openfuck/buttshock-et312-schematics/hardware/README.md

Board size: 19cm x 16.6cm
2nd PCB: 19cm x 2.5cm
(designed as single PCB and broken into two parts)

2 Layers, all through-hole components

Current work is for Revision I
