openfuck/buttshock-et312-schematics/hardware/datasheets/cd4066.png

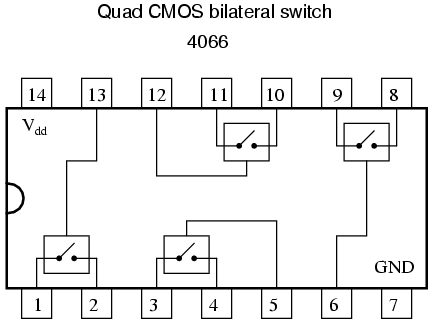
hardware/datasheets/cd4066.png
