openfuck/buttshock-et312-schematics/hardware/datasheets/LM358 pinout.JPG

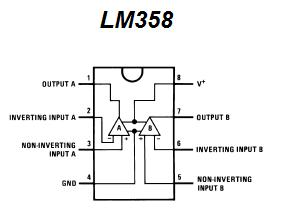
hardware/datasheets/LM358 pinout.JPG
