openfuck/buttshock-et312-schematics/hardware/schematics/et312.brd

## EAGLE design hardware/schematics/et312.brd (2016-06-19)

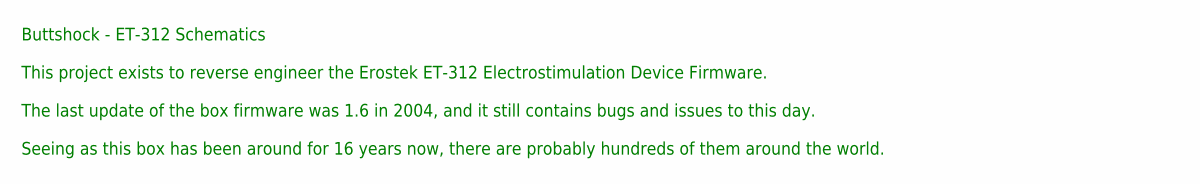
[picture p3: schematic et312.sch, sheet 1, Description Page]

Notes on the sheet:
Buttshock - ET-312 Schematics This project exists to reverse engineer the Erostek ET-312 Electrostimulation Device Firmware. The last update of the box firmware was 1.6 in 2004, and it still contains bugs and issues to this day. Seeing as this box has been around for 16 years now, there are probabl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

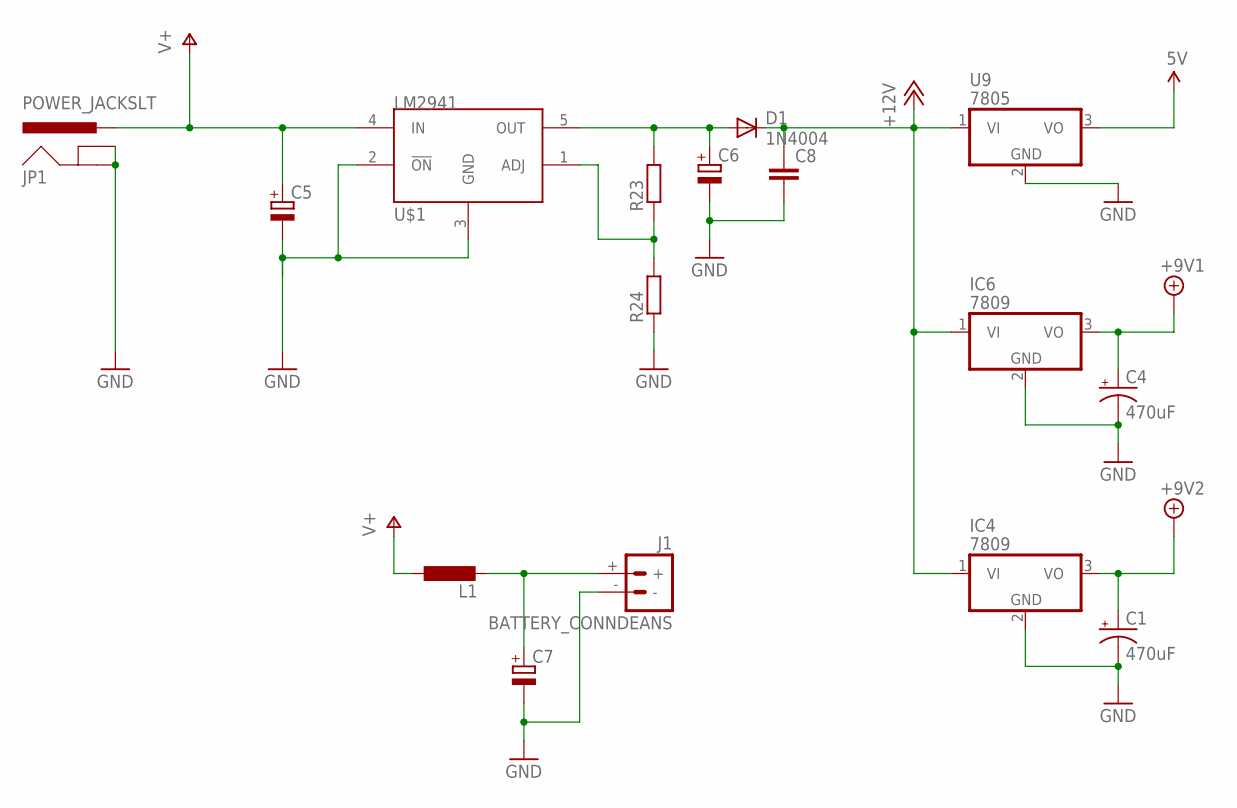
[picture p4: schematic et312.sch, sheet 2, PSU]

Parts:
C1, C4: 470uF; CPOL-RADIAL-100UF-25V
C5: CPOL-EUE2.5-6; E2,5-6
C6, C7: CPOL-EUE3.5-10; E3,5-10
C8: C-EU050-025X075; C050-025X075
D1: 1N4004; DO41-10
IC4, IC6: 7809; TO220H
J1: BATTERY_CONNDEANS; DEANS
JP1: POWER_JACKSLT; POWER_JACK_SLOT
L1: L-EU0207/10; 0207/10
R23, R24: R-EU_0204/7; 0204/7
U9: 7805; TO220H
U$1: LM2941; T05A

Connections:
5V: U9.3 (VO); also elsewhere on the board
+9V1: C4.1 (+), IC6.3 (VO); also elsewhere on the board
+9V2: C1.1 (+), IC4.3 (VO); also elsewhere on the board
+12V: C8.1, D1.C, IC4.1 (VI), IC6.1 (VI), U9.1 (VI); also elsewhere on the board
GND: C1.2 (-), C4.2 (-), C5.-, C6.-, C7.-, C8.2, IC4.2 (GND), IC6.2 (GND), J1.-, JP1.GND@1 (GNDBREAK), JP1.GND@2 (GND), R24.1, U9.2 (GND), U$1.2 (!ON), U$1.3 (GND); also elsewhere on the board
unnamed: C7.+, J1.+, L1.2
unnamed: R23.1, R24.2, U$1.1 (ADJ)
unnamed: C6.+, D1.A, R23.2, U$1.5 (OUT)
V+: C5.+, JP1.PWR, L1.1, U$1.4 (IN); also elsewhere on the board

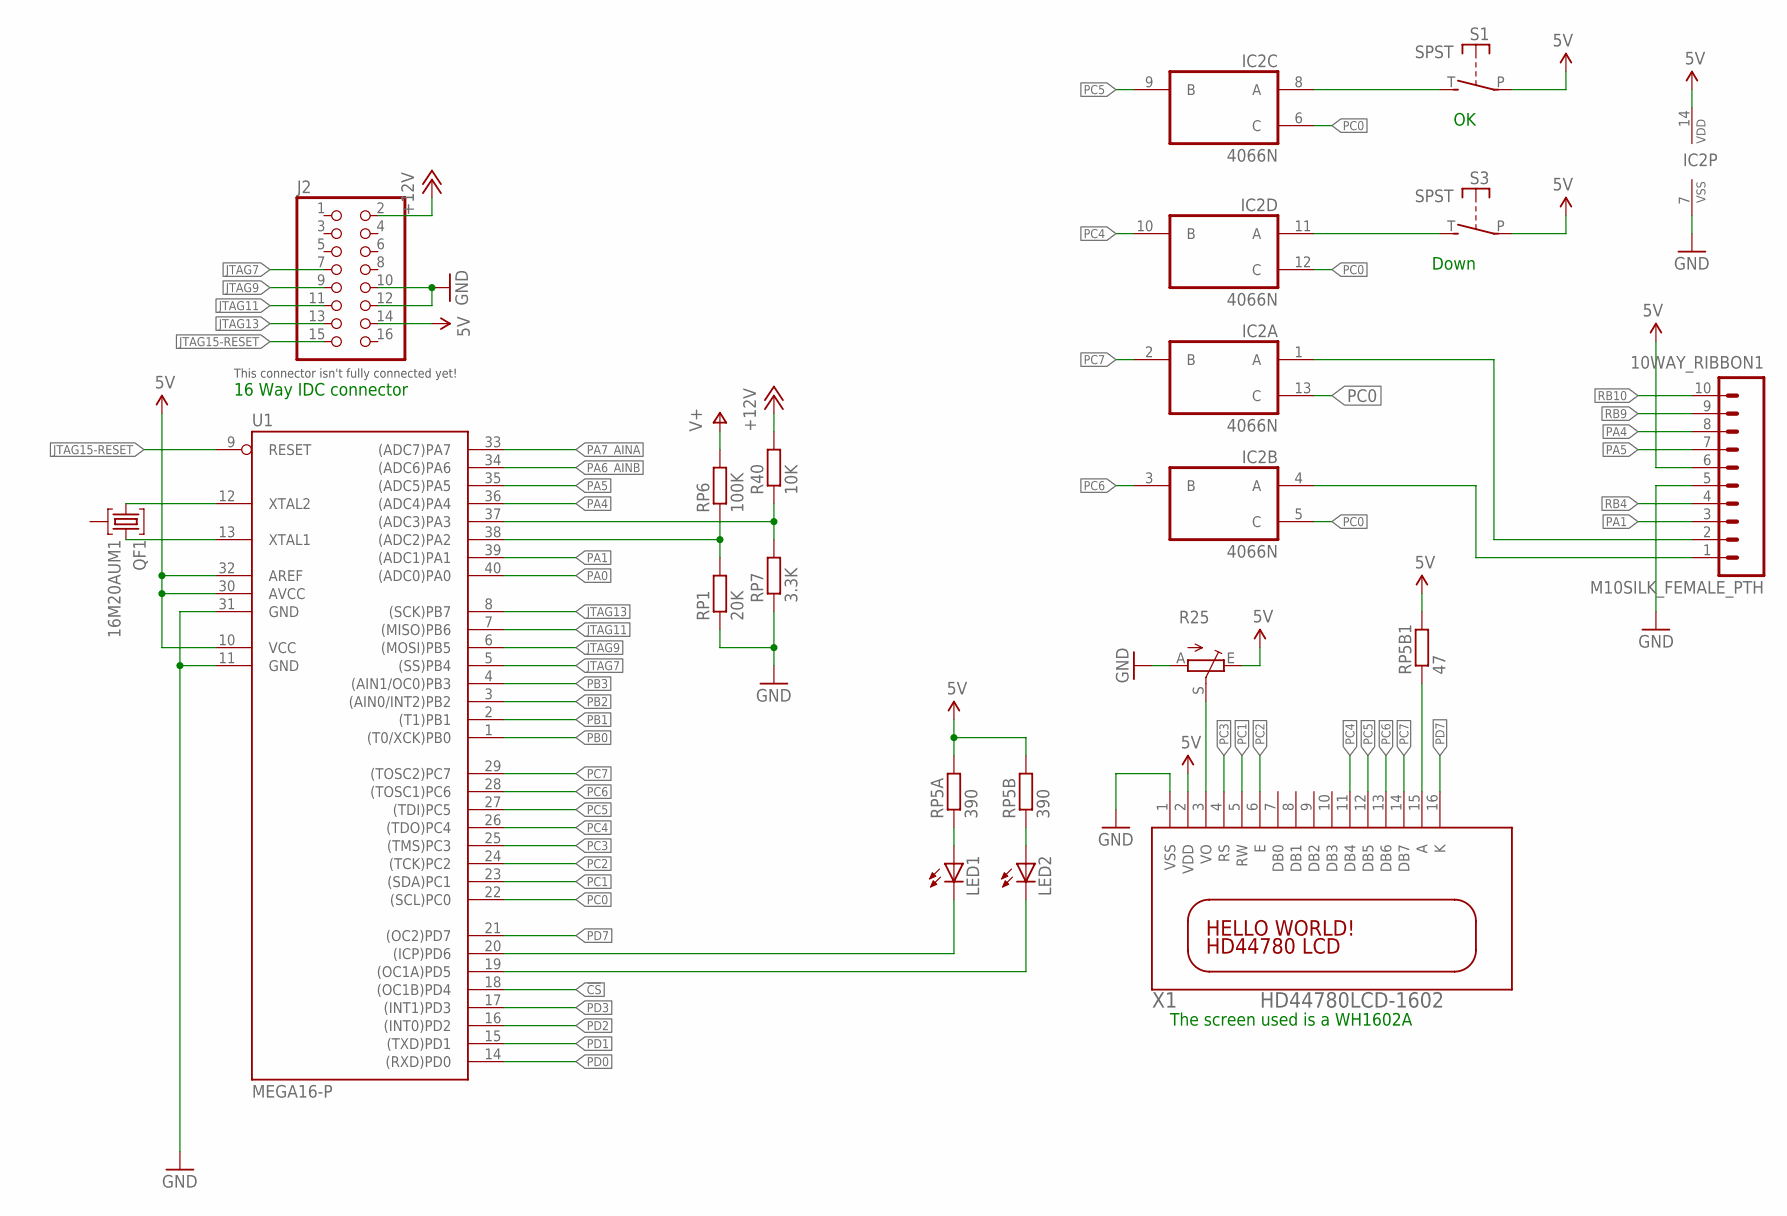
[picture p5: schematic et312.sch, sheet 3]

Parts:
10WAY_RIBBON1: M10SILK_FEMALE_PTH; 1X10
IC2: 4066N; DIL14
J2: PINHD-2X8; 2X08
LED1, LED2: LED3MM
QF1: 16M20AUM1; UM1
R25: TRIM_EU-LI10; LI10
R40: 10K; 0207/7
RP1: 20K; 0207/7
RP5A, RP5B: 390; 0207/7
RP5B1: 47; 0207/7
RP6: 100K; 0207/7
RP7: 3.3K; 0207/7
S1, S3: SPST; JUDCOSPST
U1: MEGA16-P; DIL40
X1: HD44780LCD-1602; LCD1602

Connections:
5V: 10WAY_RIBBON1.6, IC2.14 (VDD), J2.14, R25.E, RP5A.2, RP5B.2, RP5B1.2, S1.P, S3.P, U1.10 (VCC), U1.30 (AVCC), U1.32 (AREF), X1.2 (VDD); also elsewhere on the board
!CS: U1.18 ((OC1B)PD4); also elsewhere on the board
+12V: J2.2, R40.2; also elsewhere on the board
GND: 10WAY_RIBBON1.5, IC2.7 (VSS), J2.10, J2.12, R25.A, RP1.1, RP7.1, U1.11 (GND), U1.31 (GND), X1.1 (VSS); also elsewhere on the board
JTAG7: J2.7, U1.5 ((SS)PB4)
JTAG9: J2.9, U1.6 ((MOSI)PB5); also elsewhere on the board
JTAG11: J2.11, U1.7 ((MISO)PB6)
JTAG13: J2.13, U1.8 ((SCK)PB7); also elsewhere on the board
JTAG15-RESET: J2.15, U1.9 (RESET)
unnamed: IC2.8 (A), S1.T (S)
unnamed: IC2.11 (A), S3.T (S)
unnamed: 10WAY_RIBBON1.1, IC2.4 (A)
unnamed: 10WAY_RIBBON1.2, IC2.1 (A)
unnamed: QF1.3, U1.13 (XTAL1)
unnamed: LED2.A, RP5B.1
unnamed: LED1.A, RP5A.1
unnamed: R25.S, X1.3 (VO)
unnamed: QF1.1, U1.12 (XTAL2)
unnamed: RP5B1.1, X1.15 (A)
PA0: U1.40 ((ADC0)PA0); also elsewhere on the board
PA1: 10WAY_RIBBON1.3, U1.39 ((ADC1)PA1); also elsewhere on the board
PA4: 10WAY_RIBBON1.8, R40.1, RP7.2, U1.36 ((ADC4)PA4), U1.37 ((ADC3)PA3)
PA5: 10WAY_RIBBON1.7, RP1.2, RP6.1, U1.35 ((ADC5)PA5), U1.38 ((ADC2)PA2)
PA6_AINB: U1.34 ((ADC6)PA6); also elsewhere on the board
PA7_AINA: U1.33 ((ADC7)PA7); also elsewhere on the board
PB0: U1.1 ((T0/XCK)PB0); also elsewhere on the board
PB1: U1.2 ((T1)PB1); also elsewhere on the board
PB2: U1.3 ((AIN0/INT2)PB2); also elsewhere on the board
PB3: U1.4 ((AIN1/OC0)PB3); also elsewhere on the board
PC0: IC2.5 (C), IC2.6 (C), IC2.12 (C), IC2.13 (C), U1.22 ((SCL)PC0)
PC1: U1.23 ((SDA)PC1), X1.5 (RW)
PC2: U1.24 ((TCK)PC2), X1.6 (E)
PC3: U1.25 ((TMS)PC3), X1.4 (RS)
PC4: IC2.10 (B), U1.26 ((TDO)PC4), X1.11 (DB4)
PC5: IC2.9 (B), U1.27 ((TDI)PC5), X1.12 (DB5)
PC6: IC2.3 (B), U1.28 ((TOSC1)PC6), X1.13 (DB6)
PC7: IC2.2 (B), U1.29 ((TOSC2)PC7), X1.14 (DB7)
PD0: U1.14 ((RXD)PD0); also elsewhere on the board
PD1: U1.15 ((TXD)PD1); also elsewhere on the board
PD2: U1.16 ((INT0)PD2); also elsewhere on the board
PD3: U1.17 ((INT1)PD3); also elsewhere on the board
PD5: LED2.K (C), U1.19 ((OC1A)PD5)
PD6: LED1.K (C), U1.20 ((ICP)PD6)
PD7: U1.21 ((OC2)PD7), X1.16 (K)
RB4: 10WAY_RIBBON1.4; also elsewhere on the board
RB9: 10WAY_RIBBON1.9; also elsewhere on the board
RB10: 10WAY_RIBBON1.10; also elsewhere on the board
V+: RP6.2; also elsewhere on the board

Notes on the sheet:
16 Way IDC connector
The screen used is a WH1602A
Down
This connector isn't fully connected yet!

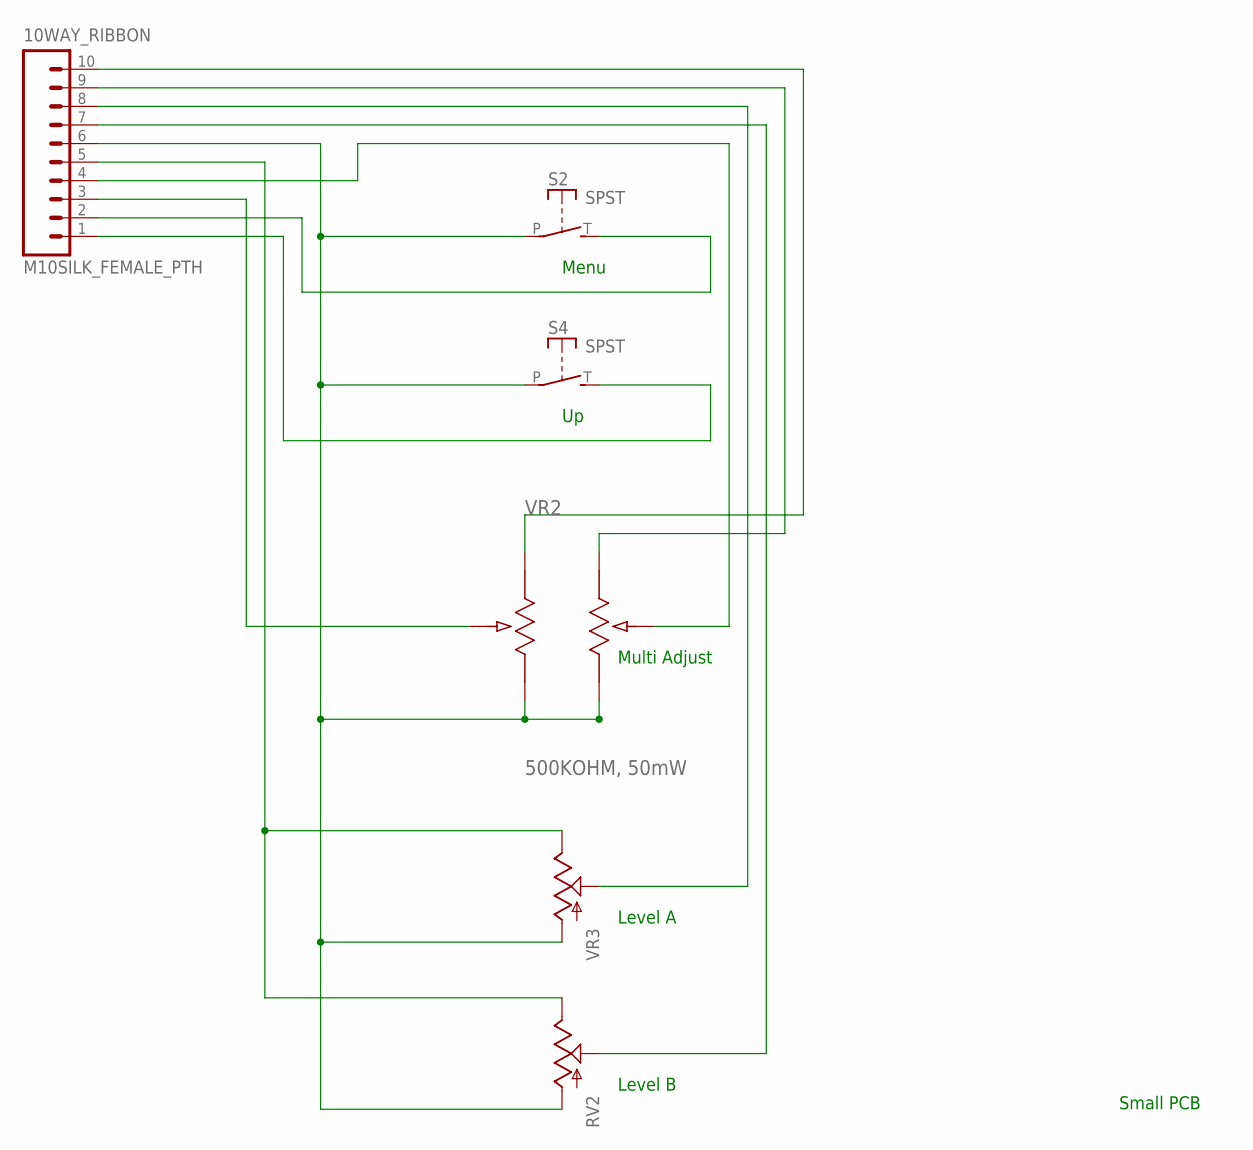
[picture p6: schematic et312.sch, sheet 4, Small PCB]

Parts:
10WAY_RIBBON: M10SILK_FEMALE_PTH; 1X10
RV2: POT; ALPS_POT
S2, S4: SPST; JUDCOSPST
VR2: 500KOHM, 50mW; POT_EVJC20
VR3: POT; ALPS_POT

Connections:
unnamed: 10WAY_RIBBON.6, RV2.P$3 (A), S2.P, S4.P, VR2.1, VR2.1', VR3.P$3 (A)
unnamed: 10WAY_RIBBON.2, S2.T (S)
unnamed: 10WAY_RIBBON.1, S4.T (S)
unnamed: 10WAY_RIBBON.9, VR2.3'
unnamed: 10WAY_RIBBON.8, VR3.P$2 (S)
unnamed: 10WAY_RIBBON.7, RV2.P$2 (S)
unnamed: 10WAY_RIBBON.10, VR2.3
unnamed: 10WAY_RIBBON.4, VR2.2'
unnamed: 10WAY_RIBBON.3, VR2.2
VR4: 10WAY_RIBBON.5, RV2.P$1 (E), VR3.P$1 (E)

Notes on the sheet:
Small PCB
Menu
Level A
Level B
Multi Adjust

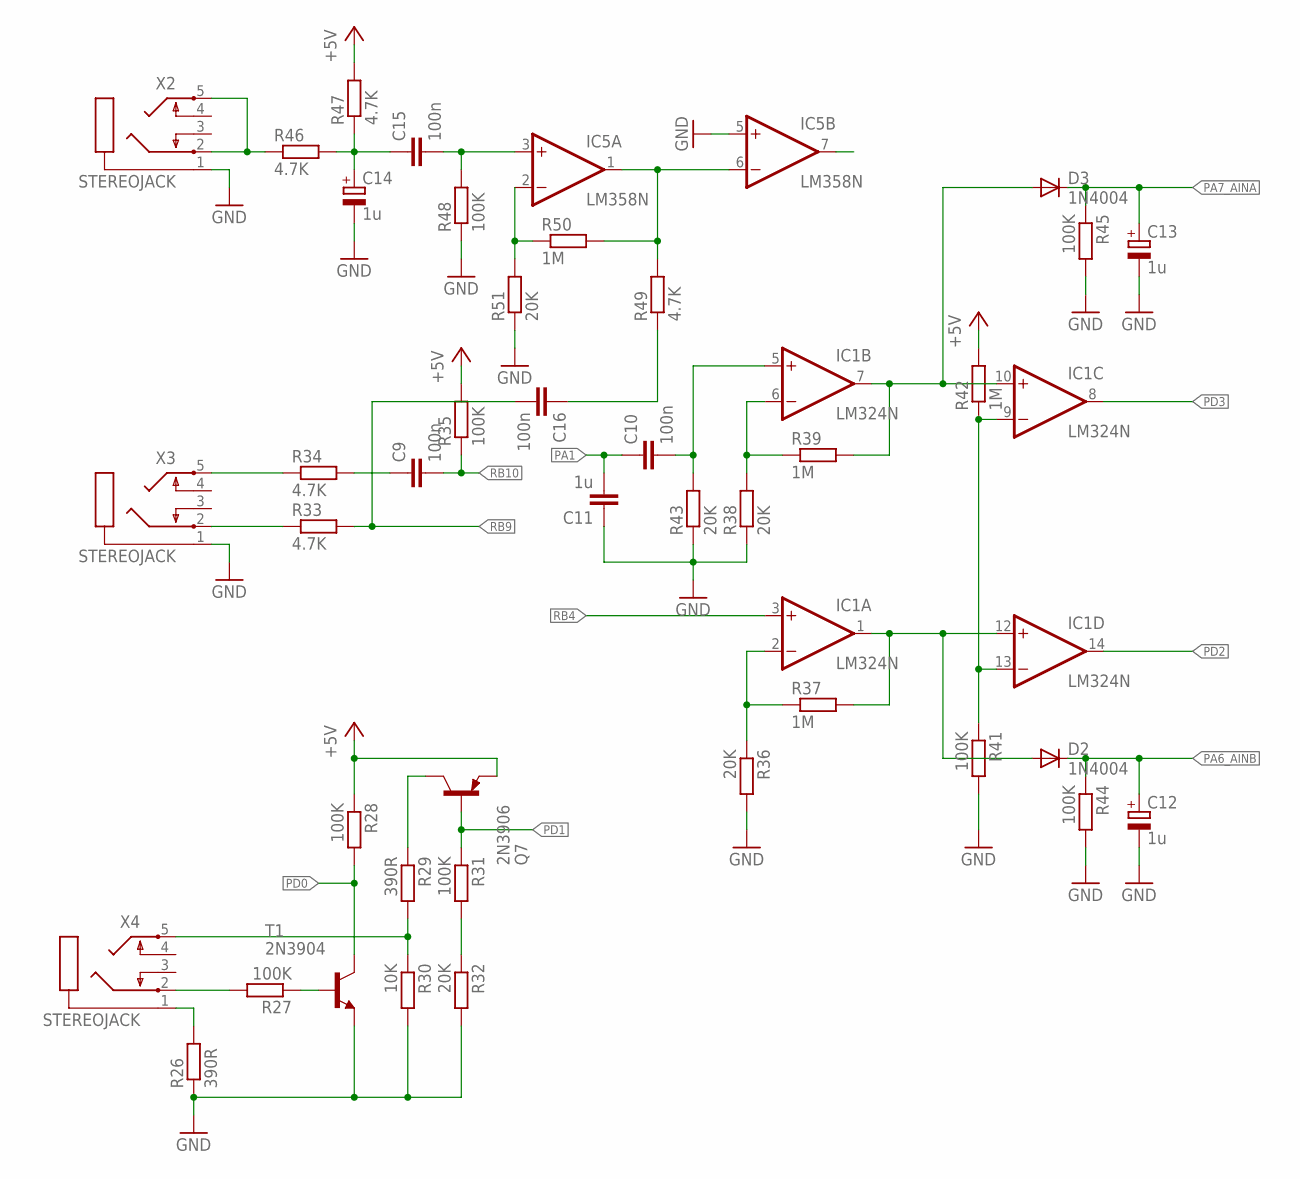
[picture p7: schematic et312.sch, sheet 5, Input stage]

Parts:
C9, C10, C15, C16: 100n; C050-025X075
C11: 1u; C050-025X075
C12, C13, C14: 1u; E2,5-5
D2, D3: 1N4004; DO41-10
IC1: LM324N; DIL14
IC5: LM358N; DIL08
Q7: 2N3906; TO92
R26, R29: 390R; 0207/10
R27, R28, R31, R35, R41, R44, R45, R48: 100K; 0207/10
R30: 10K; 0207/10
R32, R36, R38, R43, R51: 20K; 0207/10
R33, R34, R46, R47, R49: 4.7K; 0207/10
R37, R39, R42, R50: 1M; 0207/10
T1: 2N3904; TO92
X2, X3, X4: STEREOJACK; STX3100

Connections:
+5V: Q7.3 (E), R28.1, R35.2, R42.2, R47.2
GND: C11.1, C12.-, C13.-, C14.-, IC5.5 (+IN), R26.1, R30.2, R32.2, R36.2, R38.1, R41.2, R43.1, R44.2, R45.2, R48.1, R51.1, T1.3 (E), X2.1, X3.1; also elsewhere on the board
unnamed: R26.2, X4.1
unnamed: R29.2, R30.1, X4.5
unnamed: R27.2, X4.2
unnamed: R27.1, T1.2 (B)
unnamed: R31.2, R32.1
unnamed: Q7.1 (C), R29.1
unnamed: IC1.2 (-IN), R36.1, R37.1
unnamed: D2.A, IC1.1 (OUT), IC1.12 (+IN), R37.2
unnamed: R33.1, X3.2
unnamed: R34.1, X3.5
unnamed: C9.1, R34.2
unnamed: IC1.6 (-IN), R38.2, R39.1
unnamed: IC1.9 (-IN), IC1.13 (-IN), R41.1, R42.1
unnamed: C10.2, IC1.5 (+IN), R43.2
unnamed: D3.A, IC1.7 (OUT), IC1.10 (+IN), R39.2
unnamed: R46.1, X2.2, X2.5
unnamed: C14.+, C15.1, R46.2, R47.1
unnamed: C15.2, IC5.3 (+IN), R48.2
unnamed: IC5.2 (-IN), R50.1, R51.2
unnamed: IC5.1 (OUT), IC5.6 (-IN), R49.2, R50.2
unnamed: C16.1, R49.1
PA1: C10.1, C11.2; also elsewhere on the board
PA6_AINB: C12.+, D2.C, R44.1; also elsewhere on the board
PA7_AINA: C13.+, D3.C, R45.1; also elsewhere on the board
PD0: R28.2, T1.1 (C); also elsewhere on the board
PD1: Q7.2 (B), R31.1; also elsewhere on the board
PD2: IC1.14 (OUT); also elsewhere on the board
PD3: IC1.8 (OUT); also elsewhere on the board
RB4: IC1.3 (+IN); also elsewhere on the board
RB9: C16.2, R33.2; also elsewhere on the board
RB10: C9.2, R35.1; also elsewhere on the board
V+: IC1.4 (V+), IC5.8 (V+); also elsewhere on the board
V-: IC1.11 (V-), IC5.4 (V-)

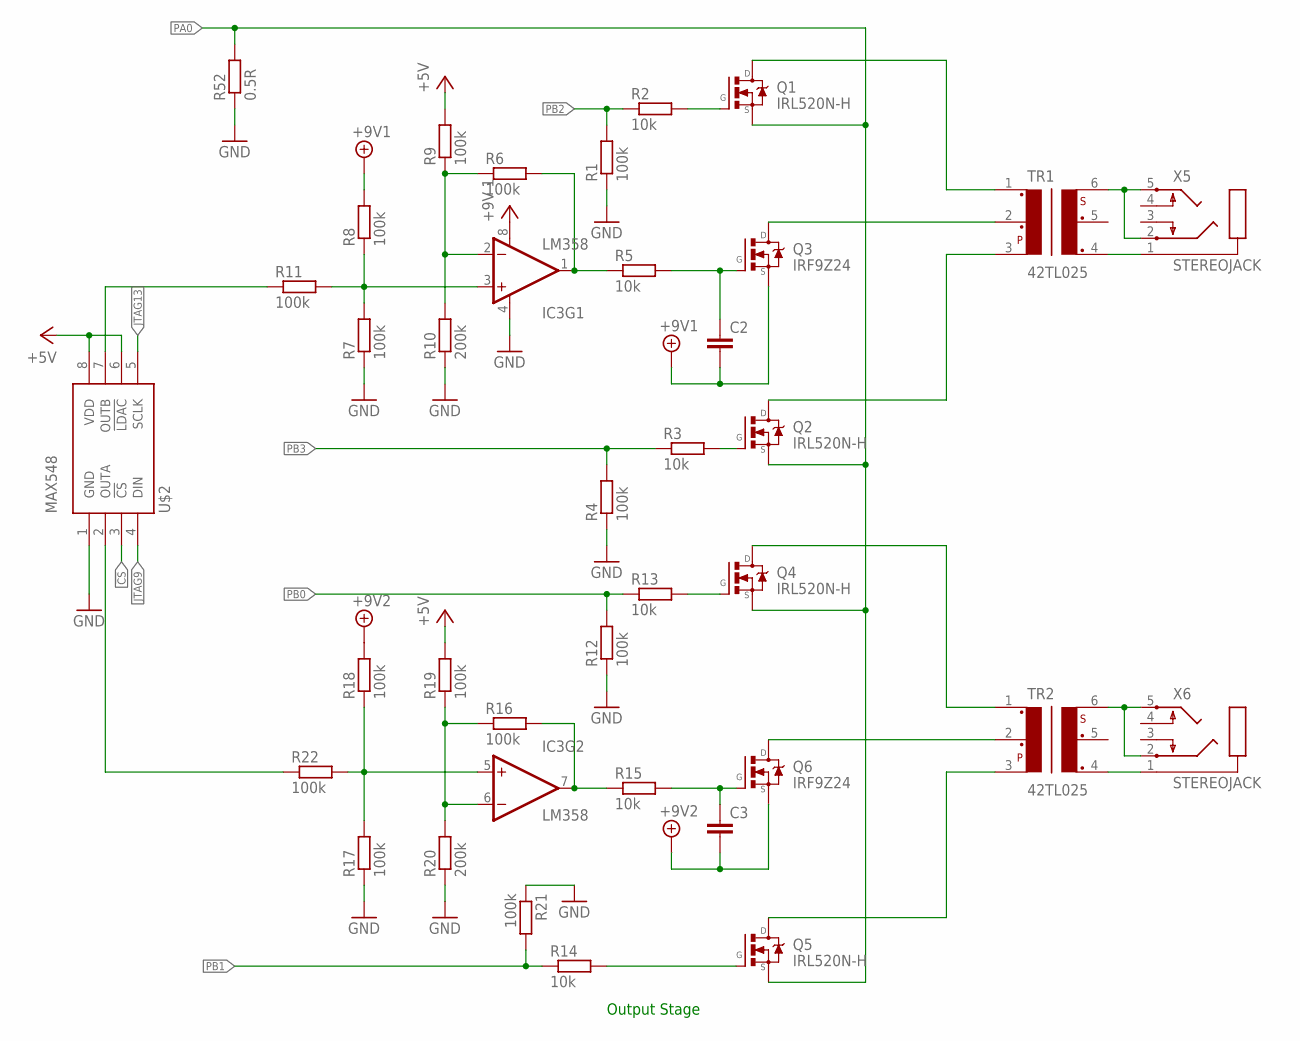
[picture p8: schematic et312.sch, sheet 6, Output stage]

Parts:
C2, C3: CAPPTH; CAP-PTH-SMALL
IC3: LM358; DIP08
Q1, Q2, Q4, Q5: IRL520N-H; TO220
Q3, Q6: IRF9Z24; TO220
R1, R4, R6, R7, R8, R9, R11, R12, R16, R17, R18, R19, R21, R22: 100k; 0207/10
R2, R3, R5, R13, R14, R15: 10k; 0207/10
R10, R20: 200k; 0207/10
R52: 0.5R; 0207/10
TR1, TR2: 42TL025; 42TL
U$2: MAX548; DIL08
X5, X6: STEREOJACK; STX3100

Connections:
!CS: U$2.3 (!CS); also elsewhere on the board
+9V1: C2.2, Q3.3 (S), R8.2; also elsewhere on the board
+9V2: C3.2, Q6.3 (S), R18.2; also elsewhere on the board
GND: IC3.4 (V-), R1.1, R4.1, R7.1, R10.1, R12.1, R17.1, R20.1, R21.1, R52.1, U$2.1 (GND); also elsewhere on the board
JTAG9: U$2.4 (DIN); also elsewhere on the board
JTAG13: U$2.5 (SCLK); also elsewhere on the board
unnamed: TR1.4, X5.1
unnamed: TR1.6, X5.2, X5.5
unnamed: Q1.1 (G), R2.2
unnamed: Q2.1 (G), R3.2
unnamed: IC3.1 (OUT), R5.1, R6.2
unnamed: C2.1, Q3.1 (G), R5.2
unnamed: IC3.3 (+IN), R7.2, R8.1, R11.2
unnamed: Q4.1 (G), R13.2
unnamed: Q5.1 (G), R14.2
unnamed: IC3.7 (OUT), R15.1, R16.2
unnamed: C3.1, Q6.1 (G), R15.2
unnamed: IC3.5 (+IN), R17.2, R18.1, R22.2
unnamed: R22.1, U$2.2 (OUTA)
unnamed: Q1.2 (D), TR1.1
unnamed: Q3.2 (D), TR1.2
unnamed: Q4.2 (D), TR2.1
unnamed: Q6.2 (D), TR2.2
unnamed: Q5.2 (D), TR2.3
unnamed: Q2.2 (D), TR1.3
unnamed: IC3.2 (-IN), R6.1, R9.1, R10.2
unnamed: IC3.6 (-IN), R16.1, R19.1, R20.2
unnamed: R11.1, U$2.7 (OUTB)
unnamed: TR2.6, X6.2, X6.5
unnamed: TR2.4, X6.1
PA0: Q1.3 (S), Q2.3 (S), Q4.3 (S), Q5.3 (S), R52.2; also elsewhere on the board
PB0: R12.2, R13.1; also elsewhere on the board
PB1: R14.1, R21.2; also elsewhere on the board
PB2: R1.2, R2.1; also elsewhere on the board
PB3: R3.1, R4.2; also elsewhere on the board
VCC: IC3.8 (V+), R9.2, R19.2, U$2.6 (!LDAC), U$2.8 (VDD)

Notes on the sheet:
Output Stage

Board: 2 copper layers, 119 parts (0 on the bottom side), 111 nets, no tracks yet.
