openfuck/buttshock-et312-schematics/(commit log)

2016-04-26 Added blank schematic
    [et312.sch]
2016-04-27 PCB WIP
    Layed down uC and some other componants
    [et312.sch]
2016-04-27 Added small board
    Added 2 buttons, and two pots to the small board, found the CD4066 in dip, and added to new sheet.
    [et312.sch]
2016-04-27 CDB4066 added
    Control pins are listed as connected to pin 22 on uC, 22 is listed as a ground… can some one please check!
    [et312.sch]
2016-04-27 fixed uC
    picked up a atmega16 rather than atmega8
    [et312.sch]
2016-04-28 Added PDF
    work done on schematic, PDF generated for people who don't have eagle.
    [et312.sch]
2016-04-28 Schematic update
    Added screen, finished buttons
    [et312.sch]
2016-04-29 moved folder to hardware
    [et312.sch]
2016-04-29 further work on the schematics
    [ET312.sch]
2016-04-30 Updated Schematics
    WIP
    [et312.sch]
2016-04-30 PCB WIP
    Added more to the PCB
    [et312.sch]
2016-04-30 update name on Pg1
    Sheet one updated
    [et312.sch]
2016-05-09 Added (hopefully) complete schematics of my Rev.E Unit. Most of the work was done by @hurgotron. Only old school hand drawn for now :)
2016-05-10 updated with output stage
    brought in Flocked's output stage, WIP
    [et312.sch]
2016-05-10 Schematics
    Name Nets
    [et312.sch]
2016-05-10 Schematics
    Continues Clean up
    [et312.sch]
2016-05-10 Schematics PDF update
    this is a snapshot of the schematics as of 2016/05/10 23:12 Skippy's Local Time
2016-05-10 Schematics PDF update
    This is a snapshot of the schematics as of 2016/05/10 23:12 Skippy's Local Time -- something stupid with pdf
2016-05-10 Schematics
    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
    [et312.sch]
2016-05-11 schemtaics
    wip
    [et312.sch]
2016-05-12 Schematics
    more wip
    [et312.sch]
2016-05-21 Updates to schematics, based on hand drawn schematics
    [et312.sch]
2016-05-25 Remove old schematics
    Remove old schematics that have had no work on them for a while.
    [ET312.sch]
2016-05-25 Starting an Arduino Sheild
    [arduino_sheild.brd, arduino_sheild.sch]
2016-05-25 Work on Schematics
    [et312.sch]
2016-06-01 Arduino Sheild Eagle
    [arduino_sheild.brd, arduino_sheild.sch, et312.brd, et312.sch]
2016-06-17 Testing to see if resistor networks help
    [arduino_shield.brd, arduino_shield.sch, et312.brd, et312.sch]
2016-06-19 nope mcnopeface
    [arduino_shield.brd, arduino_shield.sch, et312.brd, et312.sch]
2016-06-19 Changes by FluffyBit
    done:
    - changed grid to 0.1mm to help place components
    - forced all components onto 0.1mm grid
    - added gnd plane on bottom of board
    - added two caps for decoupling the DAC+OP-AMP
    - added 10K pull-up on the nCS line to the DAC
    ideas:
    - add LED on unused digital pin.
    fixes
    - IC1G2 swaped +/- input to make negative feedback
    notes:
    no decoupling on +5V (fixed)
    no bulk decoupling on +12V or +5V
    -> suggest 10uF 0805 on 5V near DAC
    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
2016-06-19 Pin Swap
    et312.sch page 6 vs 03_output_stage_1.gif, bottom opamp (pins 5 & 6)
    [et312.brd, et312.sch]
